Murek-PK/ZegarKlapkowyPL-/docs/gif2.gif

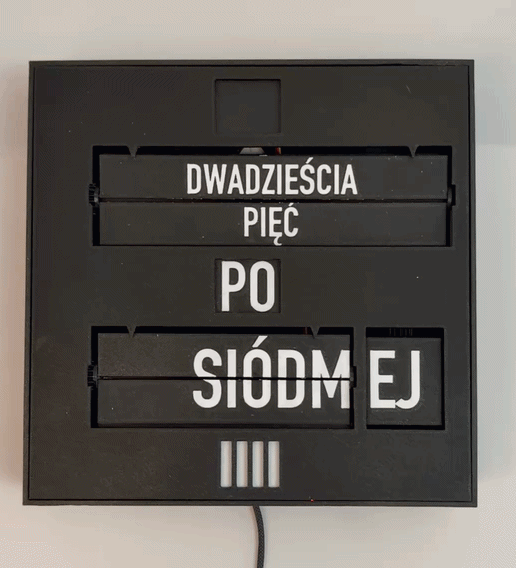
docs/gif2.gif
