Murek-PK/ZegarKlapkowyPL-/docs/IMG_7278.jpeg

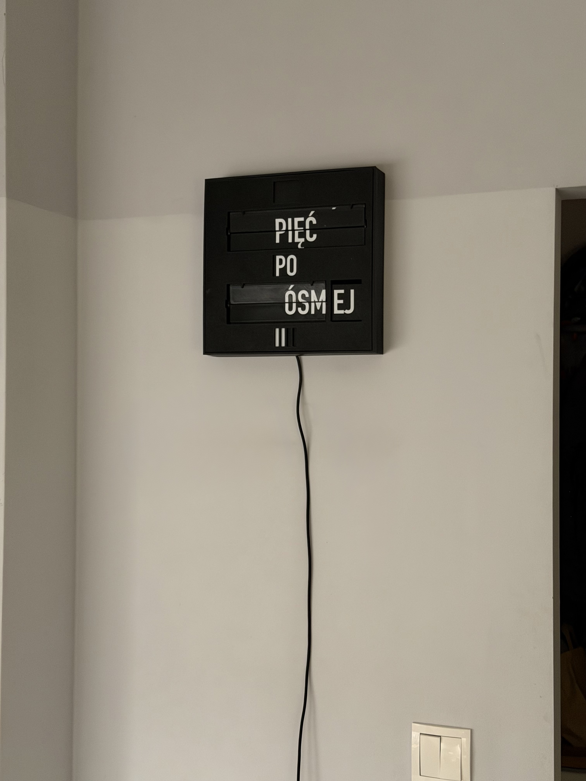
docs/IMG_7278.jpeg
