Murek-PK/ZegarKlapkowyPL-/docs/IMG_7220.jpeg

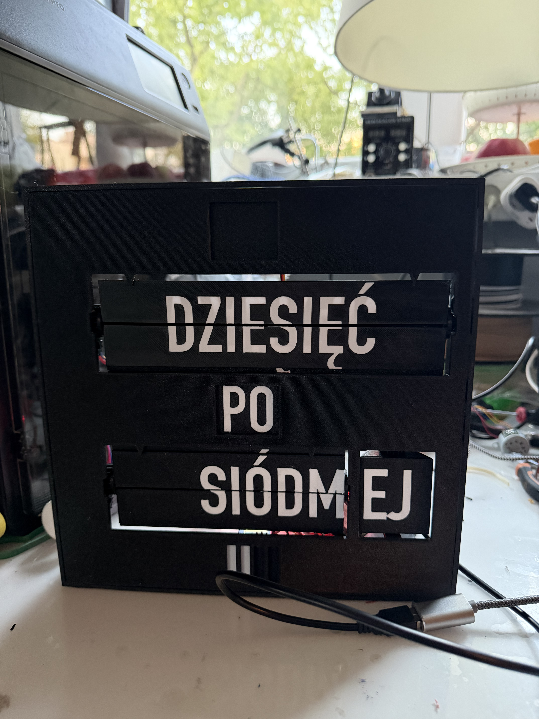
docs/IMG_7220.jpeg
